gbhug5a/Timed-Mute-TV-Remote/Pictures/Two-piece-remote2.jpg

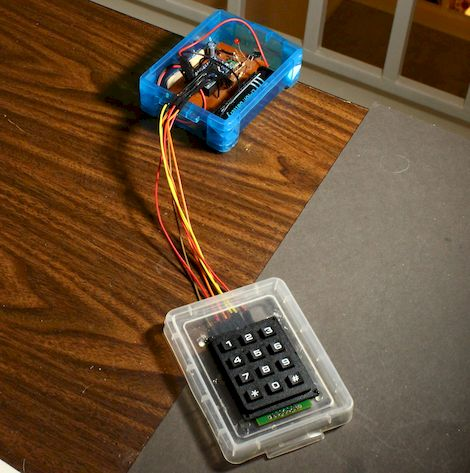
Pictures/Two-piece-remote2.jpg
