gbhug5a/Timed-Mute-TV-Remote/Pictures/Two-piece-remote.jpg

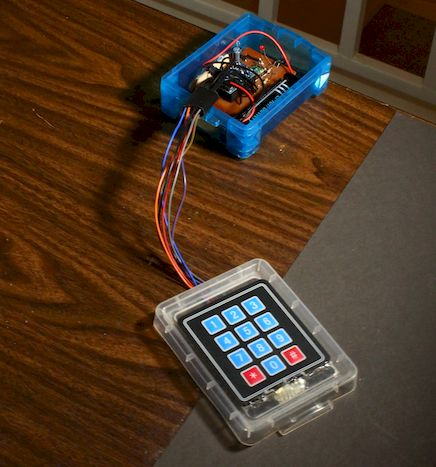
Pictures/Two-piece-remote.jpg
