gbhug5a/Timed-Mute-TV-Remote/Timed-Mute-TV-Remote-schematic.jpg

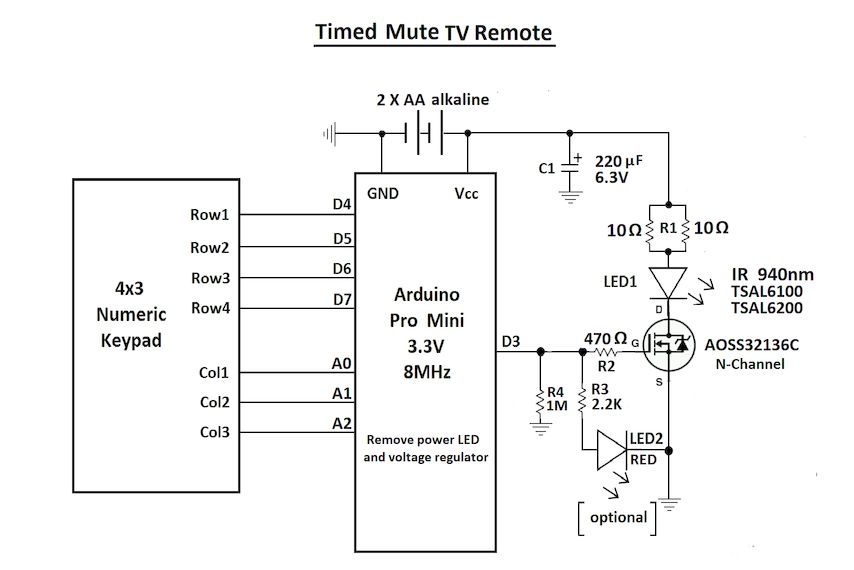
Timed-Mute-TV-Remote-schematic.jpg
